nlohr1/Power-LDO-Regulator-with-TL431-and-P-Mosfet/Power-LDO-Regulator with TL431 and P-Mosfet.png

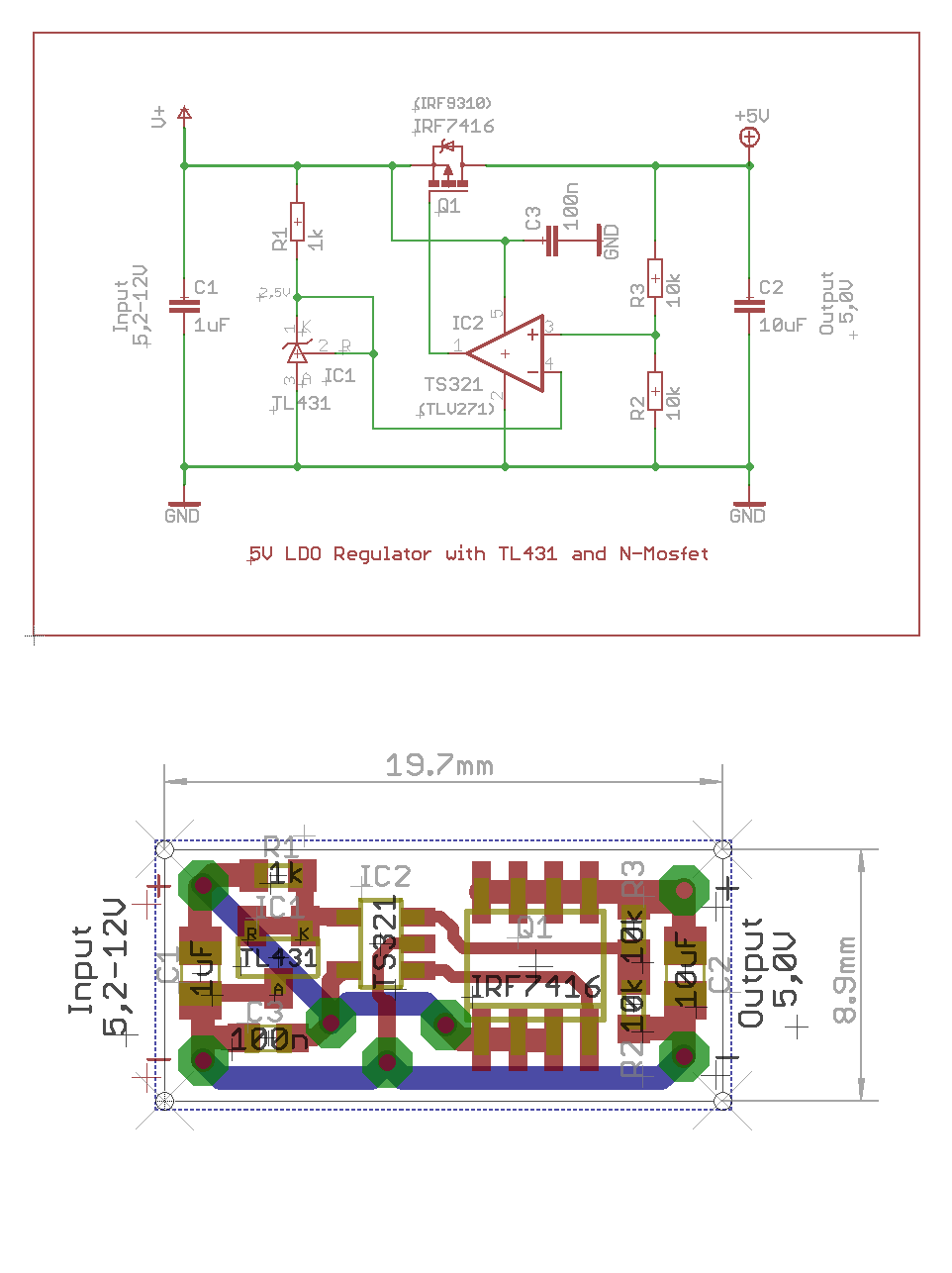
Power-LDO-Regulator with TL431 and P-Mosfet.png
