nlohr1/Power-LDO-Regulator-with-TL431-and-P-Mosfet/TL431-Block-Diagram.png

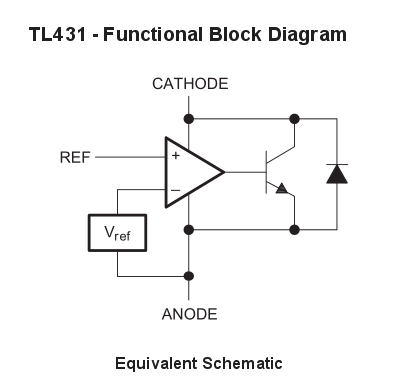
TL431-Block-Diagram.png
