nlohr1/Power-LDO-Regulator-with-TL431-and-P-Mosfet/Power-LDO-Regulator with TL431 and P-Mosfet_TonerDirect.pdf

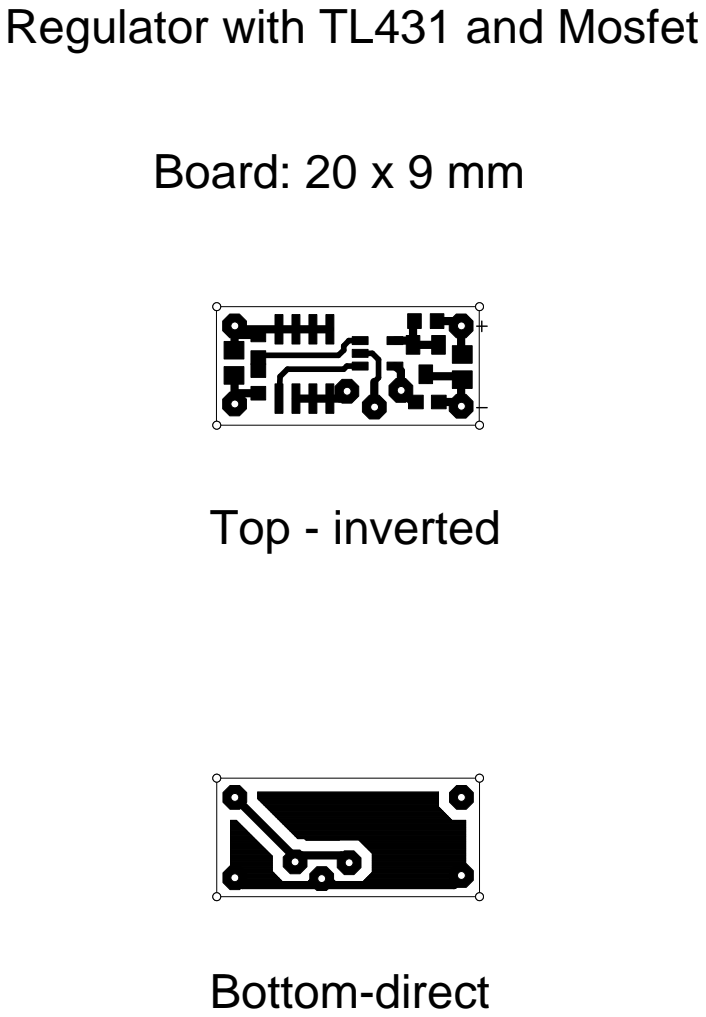
[picture p4: page 1]

Regulator with TL431 and Mosfet
