nlohr1/Power-LDO-Regulator-with-TL431-and-P-Mosfet/Power-LDO-Regulator with TL431 and P-Mosfet.brd

## EAGLE design Power-LDO-Regulator with TL431 and P-Mosfet.brd (2021-01-26)

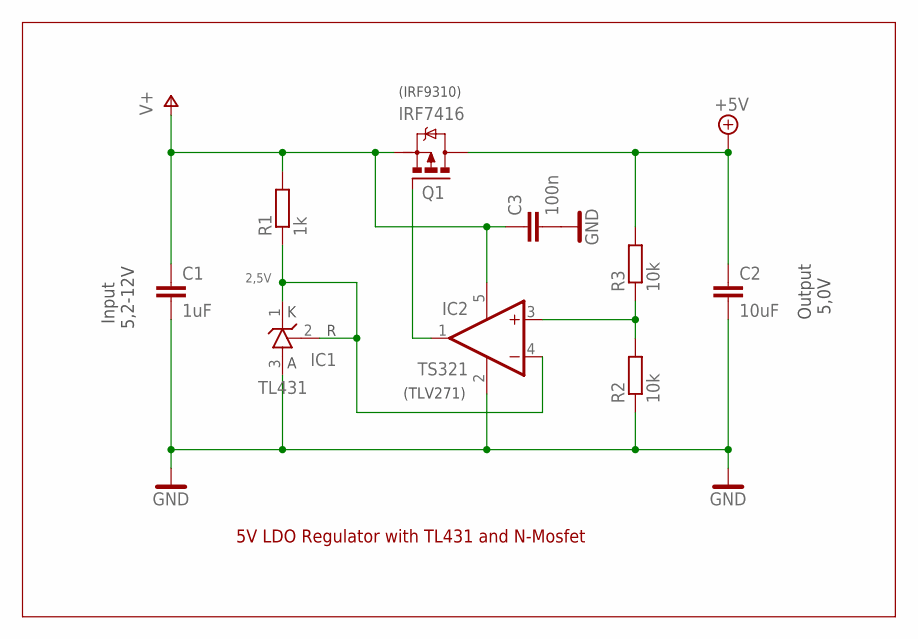
[picture p5: schematic Power-LDO-Regulator with TL431 and P-Mosfet.sch]

Parts:
C1: 1uF; C0805
C2: 10uF; C0805
C3: 100n; C0603
IC1: TL431; SOT23
IC2: TS321; SOT23-5
Q1: IRF7416; SO-08
R1: 1k; R0603
R2, R3: 10k; R0603

Connections:
+5V: C2.1, Q1.5 (D), Q1.6 (D), Q1.7 (D), Q1.8 (D), R3.2
GND: C1.2, C2.2, C3.2, IC1.3 (A), IC2.2 (GND), R2.1
unnamed: IC2.3 (+IN), R2.2, R3.1
unnamed: IC1.1 (C), IC1.2 (R), IC2.4 (-IN), R1.1
unnamed: IC2.1 (OUT), Q1.4 (G)
V+: C1.1, C3.1, IC2.5 (V+), Q1.1 (S), Q1.2 (S), Q1.3 (S), R1.2

Notes on the sheet:
5V LDO Regulator with TL431 and N-Mosfet
Input 5,2-12V
Output 5,0V
2,5V
(TLV271)
(IRF9310)

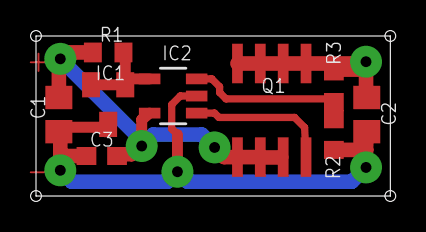
[picture p6: board Power-LDO-Regulator with TL431 and P-Mosfet.brd from above]

Board: 2 copper layers, 19.7 x 8.9 mm, 9 parts (0 on the bottom side), 6 nets.
